noelledavis/sweat-wearable-old/Documentation_graphics_folder/electrolyte_power_pinout.pptx

Top view: component side up!

GND

V+ 3.5V to 5V

FPC

Bluetooth
