noelledavis/sweat-wearable-old/Documentation_graphics_folder/electrode_layout_electrolyte.pptx

Top view: component side up!

Iontophoresis - side

FPC

Sensor Channel 1

Bluetooth
module

Reference

Sensor Channel 2

Iontophoresis + side
