noelledavis/sweat-wearable-old/Documentation_graphics_folder/electrolyte_layout.pptx

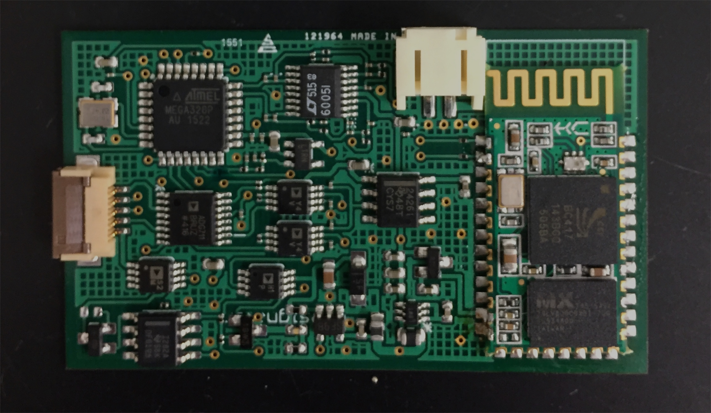
[picture p20: figure]

ATMega328P

Bluetooth

Instrumentation
Amplifier +
filters

Regulators

Analog switches

Current DAC
