noelledavis/sweat-wearable-old/Documentation_graphics_folder/eric4_electrode_layout.pptx

Top view: component side up!

Temperature pin1

Temperature pin2

Current Ch1

10-pin connector

Current reference

USB/switch

Voltage Ch1

Current Ch2

Voltage Ch2

Voltage Ch3

Voltage reference

Voltage Ch4
