noelledavis/sweat-wearable-old/Documentation_graphics_folder/labeled_circuit.pptx

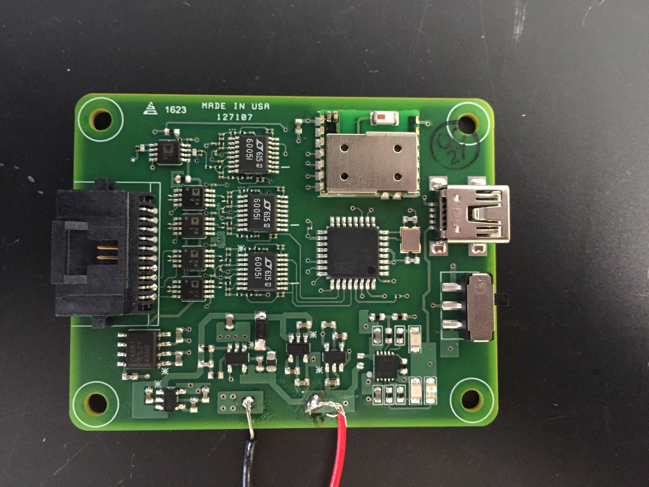
[picture p21: figure]

Current channels

Bluetooth

ATMega328P

ON/OFF switch

Charger

Regulators

Voltage
channels
