noelledavis/sweat-wearable-old/Documentation_graphics_folder/prog_layout_electrolyte.pptx

Remember to flip the board backside up!

GND

MISO

RST

Bluetooth

FPC connector

SCK

MOSI

VDD
