noelledavis/sweat-wearable-old/Documentation_graphics_folder/programmer_pinlayout.pptx

MOSI

VCC

NC

GND

RST

GND

SCK

GND

MISO

GND
