noelledavis/sweat-wearable-old/Documentation_graphics_folder/transfer_board.pptx

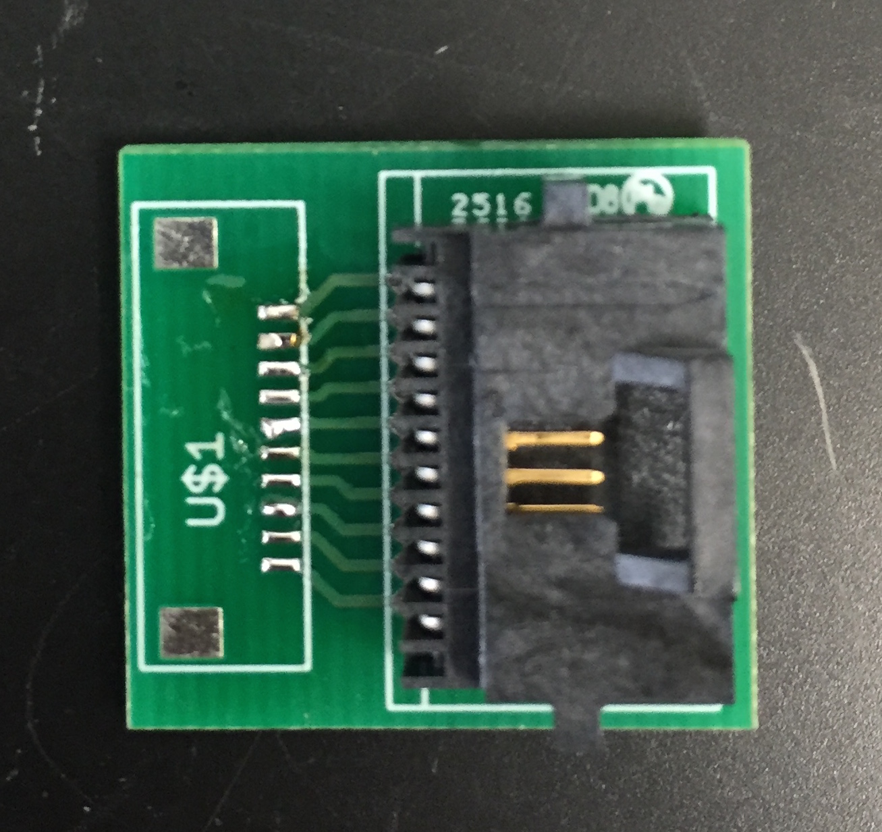
[picture p22: figure]

FPC

10-pin connector
