noelledavis/sweat-wearable-old/Documentation_graphics_folder/tia_frontend.pdf

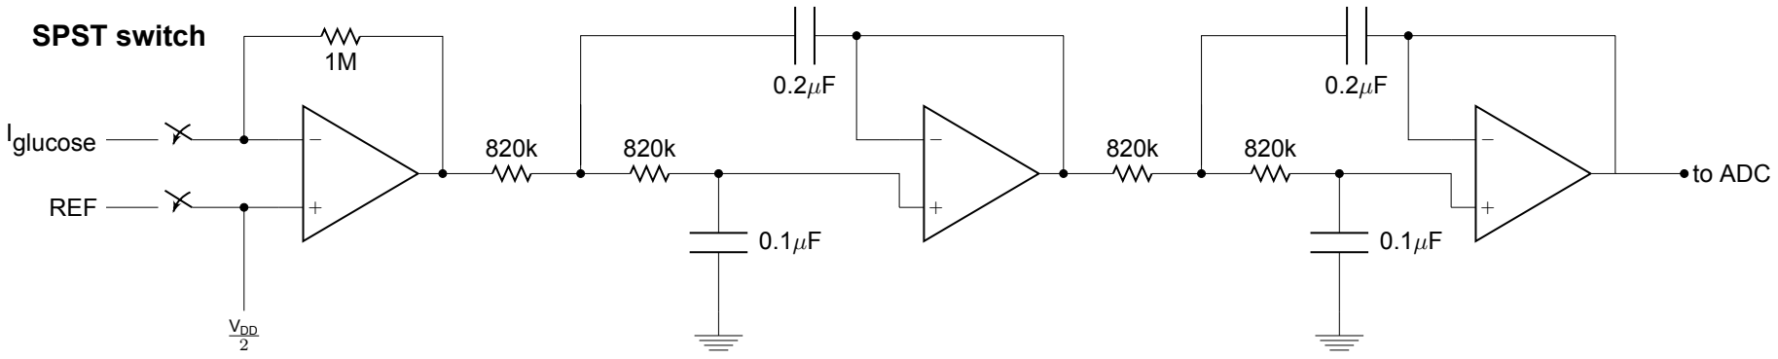
[picture p23: figure]
glucose; VDD 2; REF; SPST switch; to ADC

Transimpedance amplifier

Fourth order low-pass filter
