noelledavis/sweat-wearable-old/electrolyte/currentsource.pdf

# Suggested circuits for voltage-controlled current source for iontophoresis

Eric Wu

May 22, 2015

## 1 Option 1: AD8276 unity-gain difference amplifier and single resistor

We can try using a Howland current pump. The following schematic is taken from a document (http://www.analog.com/library/analogDialogue/cd/vol45n2.pdf) written by Analog Devices, and the datasheet for the IC is at this link. (http://www.analog.com/media/en/technical-documentation/data-sheets/AD8276_8277.pdf)

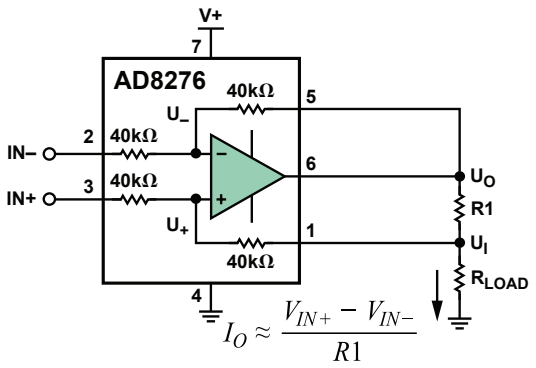
[picture p24: figure]
RLOAD

Setting R = 40 kΩ and VIN− = 0, we get the following nodal equations:

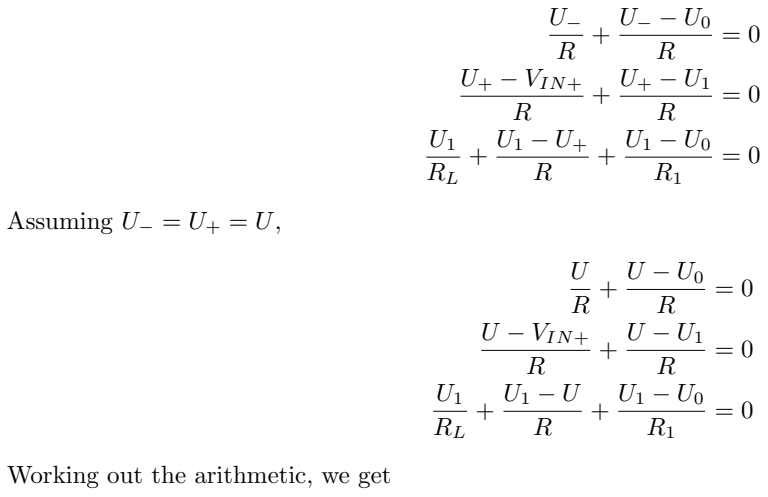
[picture p25: figure]
U+ − VIN+; Assuming U− = U+ = U,; U − VIN+; Working out the arithmetic, we get

1

U1 = VIN+ ·

(RL k 2R)
(R1 k 2R)

and

Iload =

VIN+
(2R k R1)

·

2R
RL + 2R

If we assume that 2R R1 and 2R RL (this last assumption may be a bit shaky, because I don’t exactly know the DC impedance of skin, and the impedance will also have a dependence on the area of the electrodes), we get

Iload =

VIN+
R1

Using the equations and only making the assumption 2R R1, I can find the output impedance, which is approximately 2R = 80kΩ, and therefore we can model the circuit approximately as the following:

VIN+
R1
80kΩ | RL

Depending on what the impedance of skin is, this may or may not be acceptable. If skin ends up having a much higher impedance than this circuit allows, then we may need to use a different IC.
Using R1 = 2kΩ, VDD = 30V, the complete circuit was simulated in HSPICE, with different load resistances.

2

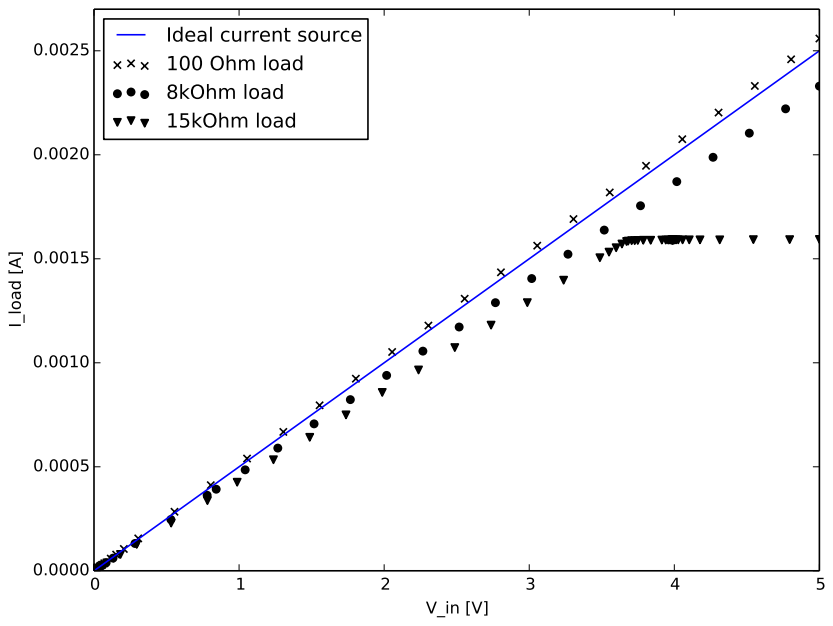
[picture p26: figure]
I_load [A]; Ideal current source; 100 Ohm load; 8kOhm load; 15kOhm load

For large loads (i.e. around 10kΩ and larger), HSPICE shows that the current gets clipped, for large values of current. This is mainly because of the upper bound imposed by VDD.

In summary:

- Vin will most likely be supplied by a DAC.
- Very simple voltage-controlled current source, requiring only a single inexpensive (about $1 or so) IC, and a single resistor
- Load is connected to ground at one end
- If we need more current, or if skin impedance is high, this particular IC is rated up to 36V VDD
- We may want to go with a different IC if skin impedance is excessively high
- It would probably be a good idea to use a unity-gain difference amplifier rather than going the DIY op-amp + resistor approach. The circuit is essentially a Howland current pump, and according to this TI document (http://www.ti.com/lit/an/snoa474a/snoa474a.pdf) the Howland current pump has a strong dependence on resistor variability. The datasheet for the IC claims that the resistors are precisely laser-trimmed, so this should help a lot with variability.

3

## 2 Option 2: AD8276 unity-gain difference amplifier with boost transistor

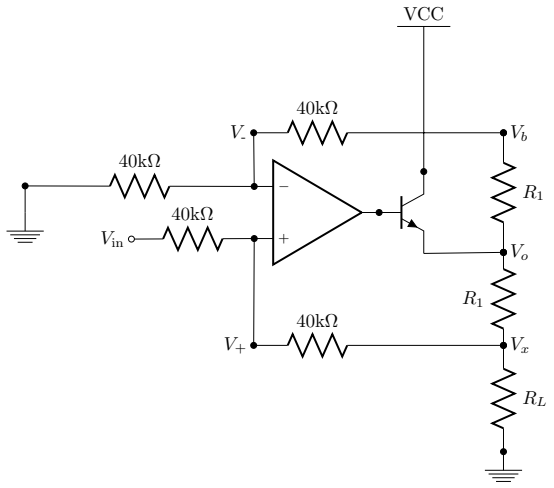
[picture p27: figure]
Vin; VCC

Note that the R = 40kΩ resistors and the op-amp are internal to the AD8276. In this circuit, VDD is the same as before, 30V, and the AD8276 positive and negative supplies are 30V and 0V respectively. This circuit can be solved very simply, using a similar approach to that given previously. The nodal equations are

V−
R

+

V− − Vb
R

= 0

V+ − Vin
R

+

V+ − Vx
R

= 0

Vb − V−
R

+

Vb − Vo
R1

= 0

Vx − V+
R

+

Vx − Vo
R1

+

Vx
RL

= 0

and working out the arithmetic, assuming that V+ = V−, gives

IL =

Vin
(R1 k R)

where R = 40kΩ. With these assumptions the circuit is something very close to an ideal current source. HSPICE simulations were then run for R1 = 2kΩ, and varying values of RL. The results are shown below.

4

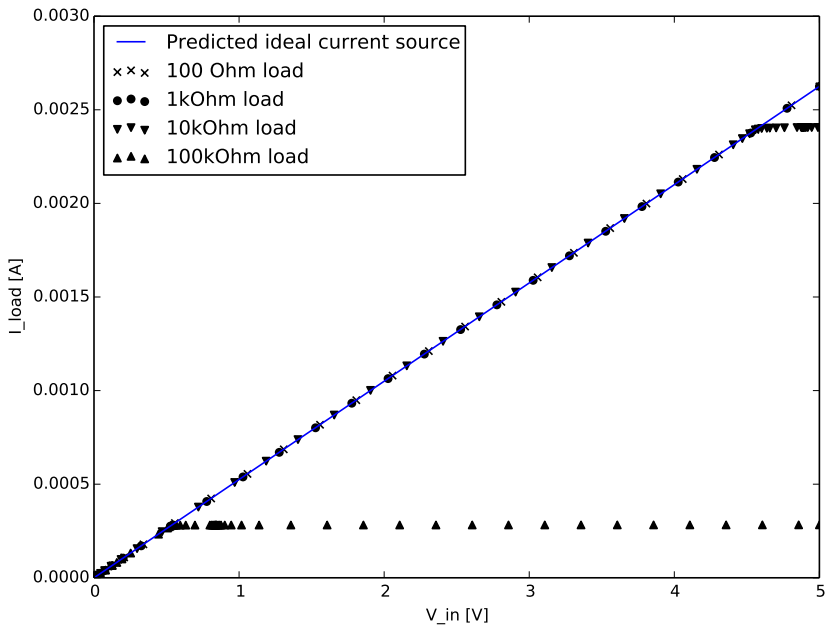
[picture p28: figure]
I_load [A]; Predicted ideal current source; 100 Ohm load; 1kOhm load; 10kOhm load; 100kOhm load

The clipping is brought upon by the upper limit imposed by VDD.

In summary:

- Vin will most likely be supplied by a DAC.
- Closer to an ideal current source than the original circuit
- Load still grounded on one end.
- A bit more complicated than the original circuit, requiring an extra resistor and a BJT
- Analog Devices claims that if the two resistors with value R1 mismatch, there may be some sort of error. Since these resistors are external, we might need high precision resistors/trimmable resistors if we were to build this circuit.

5
