noelledavis/sweat-wearable-old/Documentation_graphics_folder/erci4currentfrontend/tia_frontend.pdf

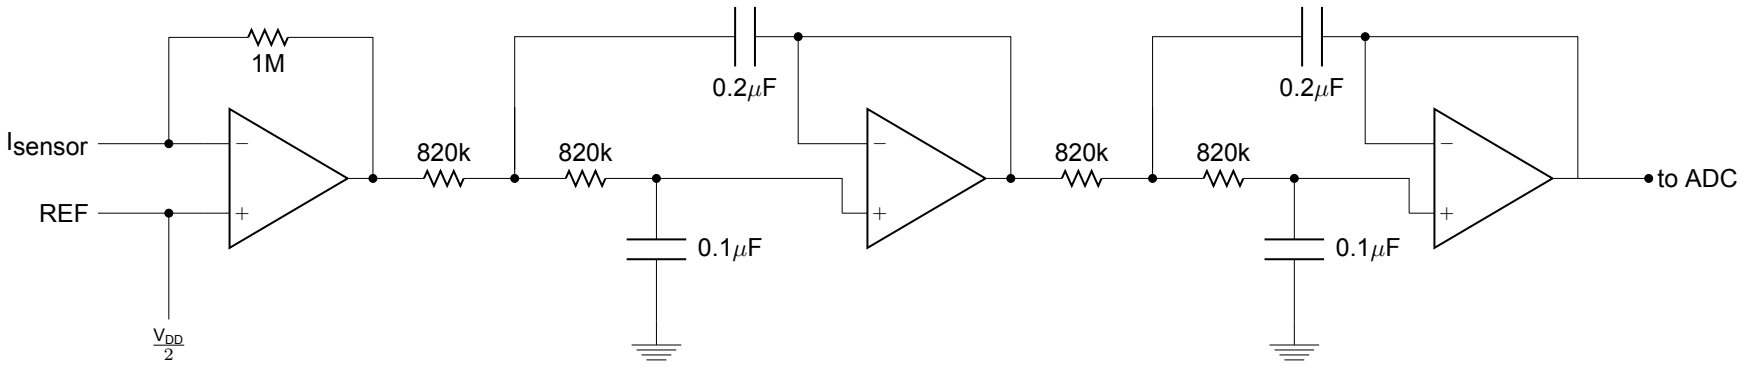
[picture p29: figure]
Isensor; VDD 2; REF; to ADC

Transimpedance amplifier

Fourth order low-pass filter
