noelledavis/sweat-wearable-old/Documentation_graphics_folder/replaceableparts.pptx

R6

R5

JUMPER
