noelledavis/sweat-wearable-old/electrolyte/electrolyte_firmware_FINAL/programming_pins.jpg

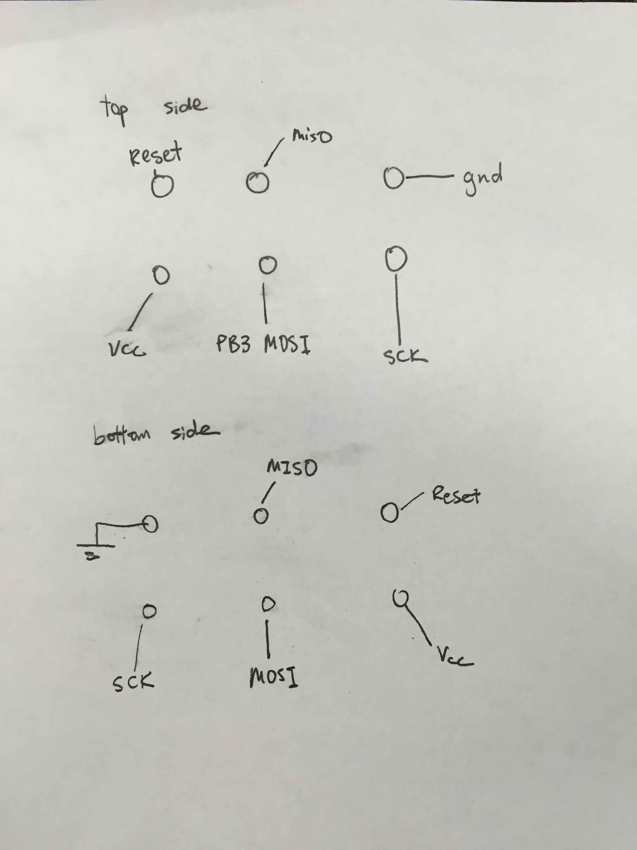
electrolyte/electrolyte_firmware_FINAL/programming_pins.jpg
