noelledavis/sweat-wearable-old/electrolyte/electrolyte_r3_orderfiles/inamp_round3_BOM.xlsx

Item # | Quantity per board | Manufacturer Part # | Do Not Install | Reference designators | Vendor (optional) | Vendor Part Number (optional) | Value (optional) | Size / Footprint (optional) | Part description/ specs (optional, but recommended) | Manfacturer (optional)
1 | 1 | CRCW02011M00FNED |  | R43 | Digikey | 541-1.00MABCT-ND | 1M | R0201 |  | Vishay-Dale
2 | 1 | MMBF5457 |  | Q1 | Digikey | MMBF5457CT-ND | MMBF5457 N-channel JFET | SOT23 |  | Fairchild
3 | 2 | GRM1555C1H200JA01D |  | C25,C26 | Digikey | 490-5930-1-ND | 20pF | C0402 | 20pF capacitor | Murata
4 | 1 | CL05B152KB5NNNC |  | CF | Digikey | 1276-1521-1-ND | 1500pF | C0402 | 50V 1500pF capacitor | Samsung
5 | 1 | LMR64010XMFE/NOPB |  | U2 | Digikey | LMR64010XMFE/NOPBCT-ND |  | SOT23-5 |  | Texas Instruments
6 | 4 | GRM155R60J105KE19D |  | C24,C68,C79,C80 | Digikey | 490-1320-1-ND | 1uF | C0402 |  | Murata
7 | 1 | INA282AIDR |  | U4 | Digikey | 296-27820-1-ND |  | SOIC-8 |  | Texas Instruments
8 | 1 | LT6005IGN#PBF |  | U3 | Digikey | LT6005IGN#PBF-ND |  | 16-SSOP |  | Linear Technologies
9 | 1 | MBR0540L-TP |  | D1 | Digikey | MBR0540L-TPMSTR-ND |  | SOD123 | 40V Schottky diode | Micro Commercial
10 | 1 | MCR006YRTJ390 |  | R26 | Digikey | RHM39CCCT-ND | 39 | R0201 |  | Rohm Semiconductor
11 | 3 | MCR006YRTF1003 |  | R65,R70,R53 | Digikey | RHM100KCBCT-ND | 100k | R0201 |  | Rohm Semiconductor
12 | 1 | CL05A225MQ5NNNC |  | C1 | Digikey | 1276-1469-1-ND | 2.2uF | C0402 |  | Samsung
13 | 1 | ADG711BRUZ |  | U6 | Digikey | ADG711BRUZ-ND |  | 16TSSOP |  | Analog Devices
14 | 1 | BC846B,215 |  | T1 | Digikey | 568-1632-1-ND |  | SOT23 | 65V NPN BJT | NXP Semiconductors
15 | 1 | FH12-5S-1SH(55) |  | U20 | Digikey | HFB105CT-ND |  |  |  | Hirose
16 | 1 |  | DNI | R27
17 | 2 | MLZ2012M100WTD25 |  | L2,L3 | Digikey | 445-17073-1-ND | 10uH | 805 |  | TDK
18 | 1 | ERJ-2RKF1332X |  | R4 | Digikey | P13.3KLCT-ND | 13.3k | R0402 |  | Panasonic
19 | 6 | CL05A106MQ5NUNC |  | C8,C13,C23,C27,C36,C74 | Digikey | 1276-1451-1-ND | 10uF capacitor | C0402 |  | Samsung
20 | 1 | LTC3525ESC6-5#TRMPBF |  | U12 | Digikey | LTC3525ESC6-5#TRMPBFCT-ND |  | SC70 | 5V boost regulator | Linear Technologies
21 | 1 | LT1800CS5#TRMPBF |  | U$5 | Digikey | LT1800CS5#TRMPBFCT-ND |  | TSOT23-5 |  | Linear Technologies
22 | 8 | ERJ-1GEF8203C |  | R10,R11,R13,R14,R20,R21,R23,R24 | Digikey | P820KABCT-ND | 820k | R0201 |  | Panasonic
23 | 2 | RC0201JR-0720KL |  | R44,R45 | Digikey | 311-20KNCT-ND | 20k | R0201 |  | Yageo
24 | 1 | S2B-PH-SM4-TB(LF)(SN) |  | CN1 | Digikey | 455-1749-1-ND |  |  | JST-PH 2 pin connector | JST
25 | 23 | GRM033R60J104KE19D |  | C3,C4,C5,C6,C7,C9,C10,C11,C12,C14,C15,C16,C17,C18,C19,C20,C21,C22,C31,C32,C33,C34,C28 | Digikey | 490-3167-1-ND | 0.1uF capacitor | C0201 |  | Murata
26 | 1 | ADG5401BRMZ |  | U$1 | Digikey | ADG5401BRMZ-ND |  |  |  | Analog Devices
27 | 1 | AP7313-33SAG-7 |  | IC2 | Digikey | AP7313-33SAG-7DICT-ND |  | SOT23 | 3.3V LDO | Diodes Incorporated
28 | 1 | GRM155R61A104KA01D |  | C76 | Digikey | 490-1318-1-ND | 0.1uF capacitor | C0402 |  | Murata
29 | 1 | C1608X5R1V475M080AC |  | C2 | Digikey | 445-9042-1-ND | 4.7uF capacitor | C0603 | 35V capacitor | TDK
30 | 2 | AD8422BRMZ |  | U7,U8 | Digikey | AD8422BRMZ-ND |  | 8-MSOP | Instrumentation amplifier | Analog Devices
31 | 1 | C0603X5R0J105M030BC |  | C30 | Digikey | 445-8008-1-ND | 1uF capacitor | C0201 |  | TDK
32 | 1 | AD8276ARMZ-R7 |  | U1 | Digikey | AD8276ARMZ-R7TR-ND |  | 8-MSOP |  | Analog Devices
33 | 1 | ATMEGA328P-AUR |  | U5 | Digikey | ATMEGA328P-AURCT-ND |  | 32-TQFP |  | Atmel
34 | 1 | NX3225SA-16.000000MHZ-T1 |  | Q3 | Digikey | 644-1100-1-ND |  |  | 16 MHz oscillator | NDK
35 | 2 | CRCW02012K20FKED |  | R1,R2 | Digikey | 541-2.20KAABCT-ND | 2.2k | R0201 |  | Vishay-Dale
36 | 2 | ERJ-1GEF4991C |  | R5,R7 | Digikey | P4.99KABTR-ND | 4.99k | R0201 |  | Panasonic
37 | 1 | CRCW0402374KFKED |  | R3 | Digikey | 541-374KLCT-ND | 374k | R0402 |  | Vishay-Dale
38 | 1 | TLE2426IDR |  | U15 | Digikey | 296-1345-1-ND |  | 8_SOIC |  | Texas Instruments
39 | 1 | RC0201JR-0710KL |  | R6 | Digikey | 311-10KNCT-ND | 10k | R0201 | 10k | Yageo
40 | 1 |  | DNI | U13
