noelledavis/sweat-wearable-old/eric4/files_for_order/everything_board_partlist_bom.xlsx

Item # | Quantity per board | Manufacturer Part # | Do Not Install | Reference designators | Vendor (optional) | Vendor Part Number (optional) | Value (optional) | Size / Footprint (optional) | Part description/ specs (optional, but recommended) | Manfacturer (optional)
1 | 3 | ERJ-2RKF1500X |  | R7;R8;R38 | Digikey | P150LCT-ND | 150 | R402 |  | Panasonic
2 | 2 |  | DNI | BATT_NEG;BATT_POS
3 | 2 | CRCW02011M00FNED |  | R35;R36 | Digikey | 541-1.00MABCT-ND | 1M | R0201 |  | Vishay-Dale
4 | 1 | LG R971-KN-1 |  | LED2 | Digikey | 475-1410-1-ND | STAT2-GREEN | CHIPLED_0805 |  | Osram-opto-semiconductors
5 | 1 | LH R974-LP-1 |  | LED3 | Digikey | 475-1415-1-ND | Power-RED | CHIPLED_0805 |  | Osram-opto-semiconductors
6 | 1 | LTST-C170KFKT |  | LED1 | Digikey | 160-1413-1-ND | STAT1-ORANGE | CHIPLED_0805 |  | Lite-on inc
7 | 4 | GRM155R60J105KE19D |  | C30;C34;C38;C58 | Digikey | 490-1320-1-ND | 1uF | C0402 |  | Murata
8 | 1 | GRM1555C1H431GA01D |  | C55 | Digikey | 490-6240-1-ND | 430p | C0402 |  | Murata
9 | 1 | RC0402JR-07150KL |  | RT2 | Digikey | 311-150KJRTR-ND | 150k | R0402 |  | Yageo
10 | 1 | RC0402JR-071KL |  | RT1 | Digikey | 311-1.0KJRCT-ND | 1K | R0402 |  | Yageo
11 | 3 | LT6005IGN#PBF |  | U2;U3;U4 | Digikey | LT6005IGN#PBF-ND |  | 16-SSOP |  | Linear Technologies
12 | 3 | GRM155R71H103KA88D |  | C4;C8;C57 | Digikey | 490-4516-1-ND | 0.01u | C0402 |  | Murata
13 |  |  | DNI | J1
14 | 1 | ATMEGA328P-AUR |  | U10 | Digikey | ATMEGA328P-AURCT-ND |  | 32-TQFP |  | Atmel
15 | 1 | AD8642ARMZ |  | U$6 | Digikey | AD8642ARMZ-ND | AD8462 | MSOP08 |  | Analog Devices
16 | 1 | MCP73833T-AMI/MF |  | U5 | Mouser | 579-MCP73833T-AMI/MF | MCP73833T-AMI/MF | DFN10_3X3MM |  | Microchip
17 | 1 | 5-104074-1 |  | U$12 | Digikey | A31852-ND | 5-104074-1-CONNECTOR | 5-104074-1-CONNECTOR |  | TE Connectivity
18 | 1 | CL05A225MQ5NNNC |  | C54 | Digikey | 1276-1469-1-ND | 2.2uF | C0402 |  | Samsung
19 | 1 | MBR0520LT1G |  | D1 | Digikey | MBR0520LT1GOSTR-ND | MBR0520LT | SOD123 |  | ON Semiconductor
20 | 2 | LP3985IM5-5.0/NOPB |  | U$5;U$7 | Digikey | LP3985IM5-5.0/NOPBCT-ND | LP3985A-50 | SOT95P280X145-5N |  | Texas Instruments
21 | 2 | GJM1555C1HR10BB01D |  | C51;C52 | Digikey | 490-3077-1-ND | 0.1p | C0402 | 0.1pF capacitor | Murata
22 | 1 | 10033526-N3212LF |  | U$10 | Digikey | 609-4700-1-ND | MINI-USB-10033526-N3212LF | MINI-USB-10033526-N3212LF | USB - mini B Receptacle Connector 5 Position Surface Mount, Right Angle, Horizontal | Amphenol FCI
23 | 4 | ERJ-1GEF4991C |  | R1;R2;R3;R4 | Digikey | P4.99KABCT-ND | 4.99k | R0201 |  | Panasonic
24 | 1 | MLZ2012M100WTD25 |  | L2 | Digikey | 445-17073-1-ND | 10uH | 805 |  | TDK
25 | 1 | RC0402FR-0746K4L |  | R26 | Digikey | 311-46.4KLRCT-ND | 46.4k | R0402 |  | Yageo
26 | 1 | RC0402FR-0713K3L |  | R25 | Digikey | YAG2974CT-ND | 13.3k | R0402 |  | Yageo
27 | 1 | MCR006YRTF1003 |  | R42 | Digikey | RHM100KCBCT-ND | 100k | R0201 |  | Rohm Semiconductor
28 | 5 | CL05A106MQ5NUNC |  | C29;C36; C53;C49;C67 | Digikey | 1276-1451-1-ND | 10uF capacitor | C0402 |  | Samsung
29 | 2 | ERJ-2RKF2001X |  | R6;R39 | Digikey | P2.00KLCT-ND | 2k | R0402 |  | Panasonic
30 | 1 | RC0402JR-0710KL |  | R40 | Digikey | 311-10KJRCT-ND | 10K/THERM | R0402 |  | Yageo
31 | 3 | GRM155R60J475ME47D |  | C32;C33;C56 | Digikey | 490-5915-1-ND | 4.7u | C0402 |  | Murata
32 | 24 | ERJ-1GEF8203C |  | R9;R10;R11;R12;R13;R14;R15;R16;R17;R18;R19;R20;R21;R22;R23;R24;R27;R28;R29;R30;R31;R32;R33;R34 | Digikey | P820KABCT-ND | 820k | R0201 |  | Panasonic
33 | 1 |  | DNI | JUMPER
34 | 1 | RC0402JR-0710KL |  | R5 | Digikey | 311-10KJRCT-ND | 10k | R0402 |  | Yageo
35 | 1 | LP3985IM5-3.3/NOPB |  | U1 | Digikey | LP3985IM5-3.3/NOPBCT-ND | LP3985IM5-3.3/NOPB | SOT95P280X145-5N |  | Texas Instruments
36 | 1 | SPBT2632C2A.AT2 |  | U$8 | Digikey | 497-13189-ND | SPBT2632C2A | SPBT2632C2A |  | STMicroelectronics
37 | 1 | GRM155R61A104KA01D |  | C61 | Digikey | 490-1318-1-ND | 0.1uF capacitor | C0402 |  | Murata
38 | 46 | GRM033R60J104KE19D |  | C1;C2;C3;C5;C6;C7;C9;C10;C11;C12;C13;C14;C15;C16;C17;C18;C19;C20;C21;C22;C23;C24;C25;C26;C27;C28;C31;C35;C37;C39;C40;C41;C42;C43;C44;C45;C46;C47;C48;C50;C60;C62;C63;C64;C68;C69 | Digikey | 490-3167-1-ND | 0.1uF capacitor | C0201 |  | Murata
39 | 4 | AD8422BRMZ |  | U$1;U$2;U$3;U$4 | Digikey | AD8422BRMZ-ND |  | 8-MSOP | Instrumentation amplifier | Analog Devices
40 | 1 | LM27313XMFX/NOPB |  | U$9 | Digikey | 296-35164-1-ND | LM27313 | SOT95P280X145-5N |  | Texas Instruments
41 | 1 | NX3225SA-16.000000MHZ-T1 |  | Q1 | Digikey | 644-1100-1-ND |  |  | 16 MHz oscillator | NDK
42 | 2 | GRM1555C1H200JA01D |  | C65;C66 | Digikey | 490-5930-1-ND | 20pF | C0402 | 20pF capacitor | Murata
43 | 1 | TLE2426IDR |  | U15 | Digikey | 296-1345-1-ND |  | 8_SOIC |  | Texas Instruments
44 | 1 | JS102011SAQN |  | U$11 | Digikey | 401-1999-1-ND | JS102011SAQN | JS102011SAQN |  | C&K Components
