noelledavis/sweat-wearable-old/Documentation_graphics_folder/prog_instructions.pptx

Remember to flip the board backside up!

MISO

SCK

RST

Switch and USB

10-pin connector

VDD

MOSI

GND
