noelledavis/sweat-wearable-old/eric4/fullboard_eaglefiles/untitled.pdf

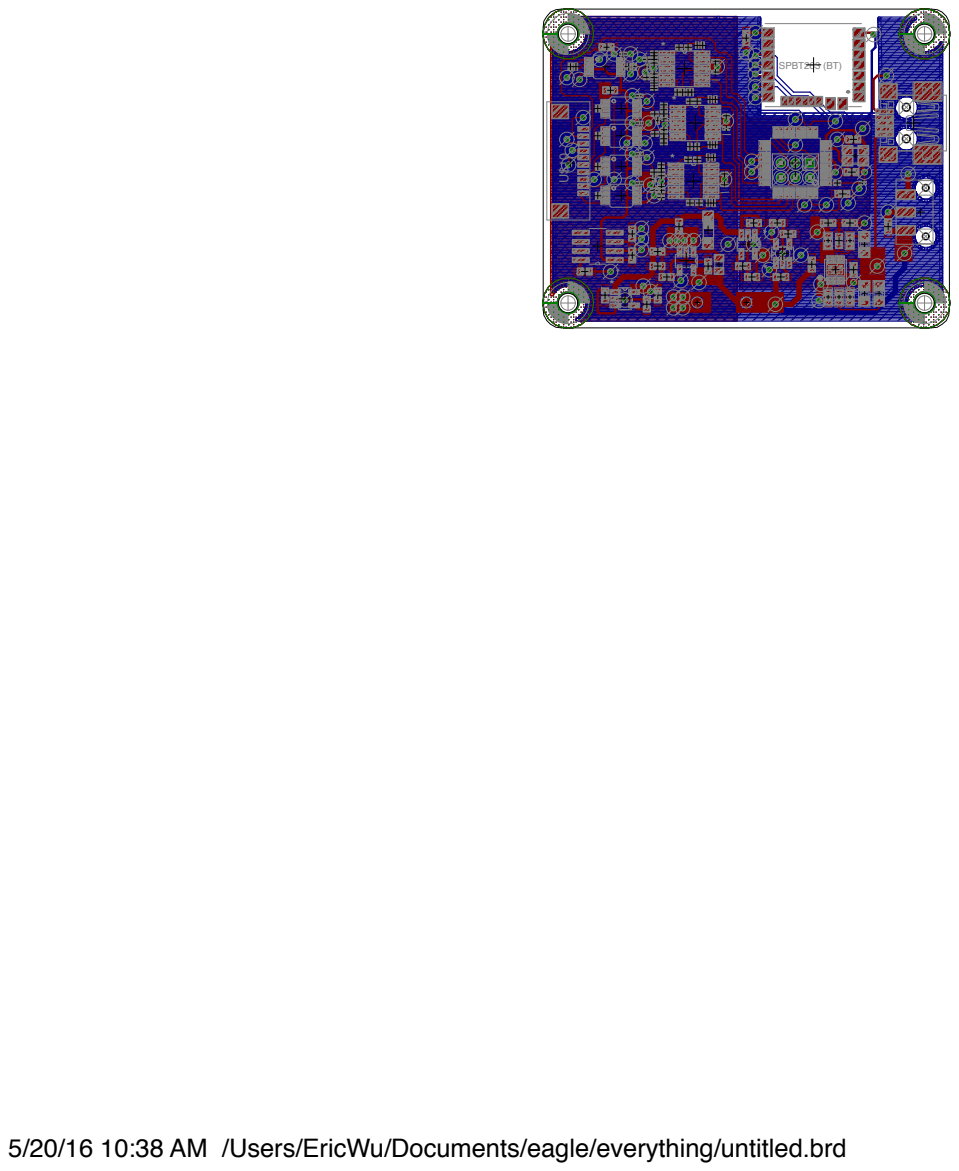
[picture p31: page 1]
SPBT263 (BT)

5/20/16 10:38 AM /Users/EricWu/Documents/eagle/everything/untitled.brd
