noelledavis/sweat-wearable-old/electrolyte/electrolyte_eaglefiles/untitled.brd

## EAGLE design electrolyte/electrolyte_eaglefiles/untitled.brd (2020-10-29)

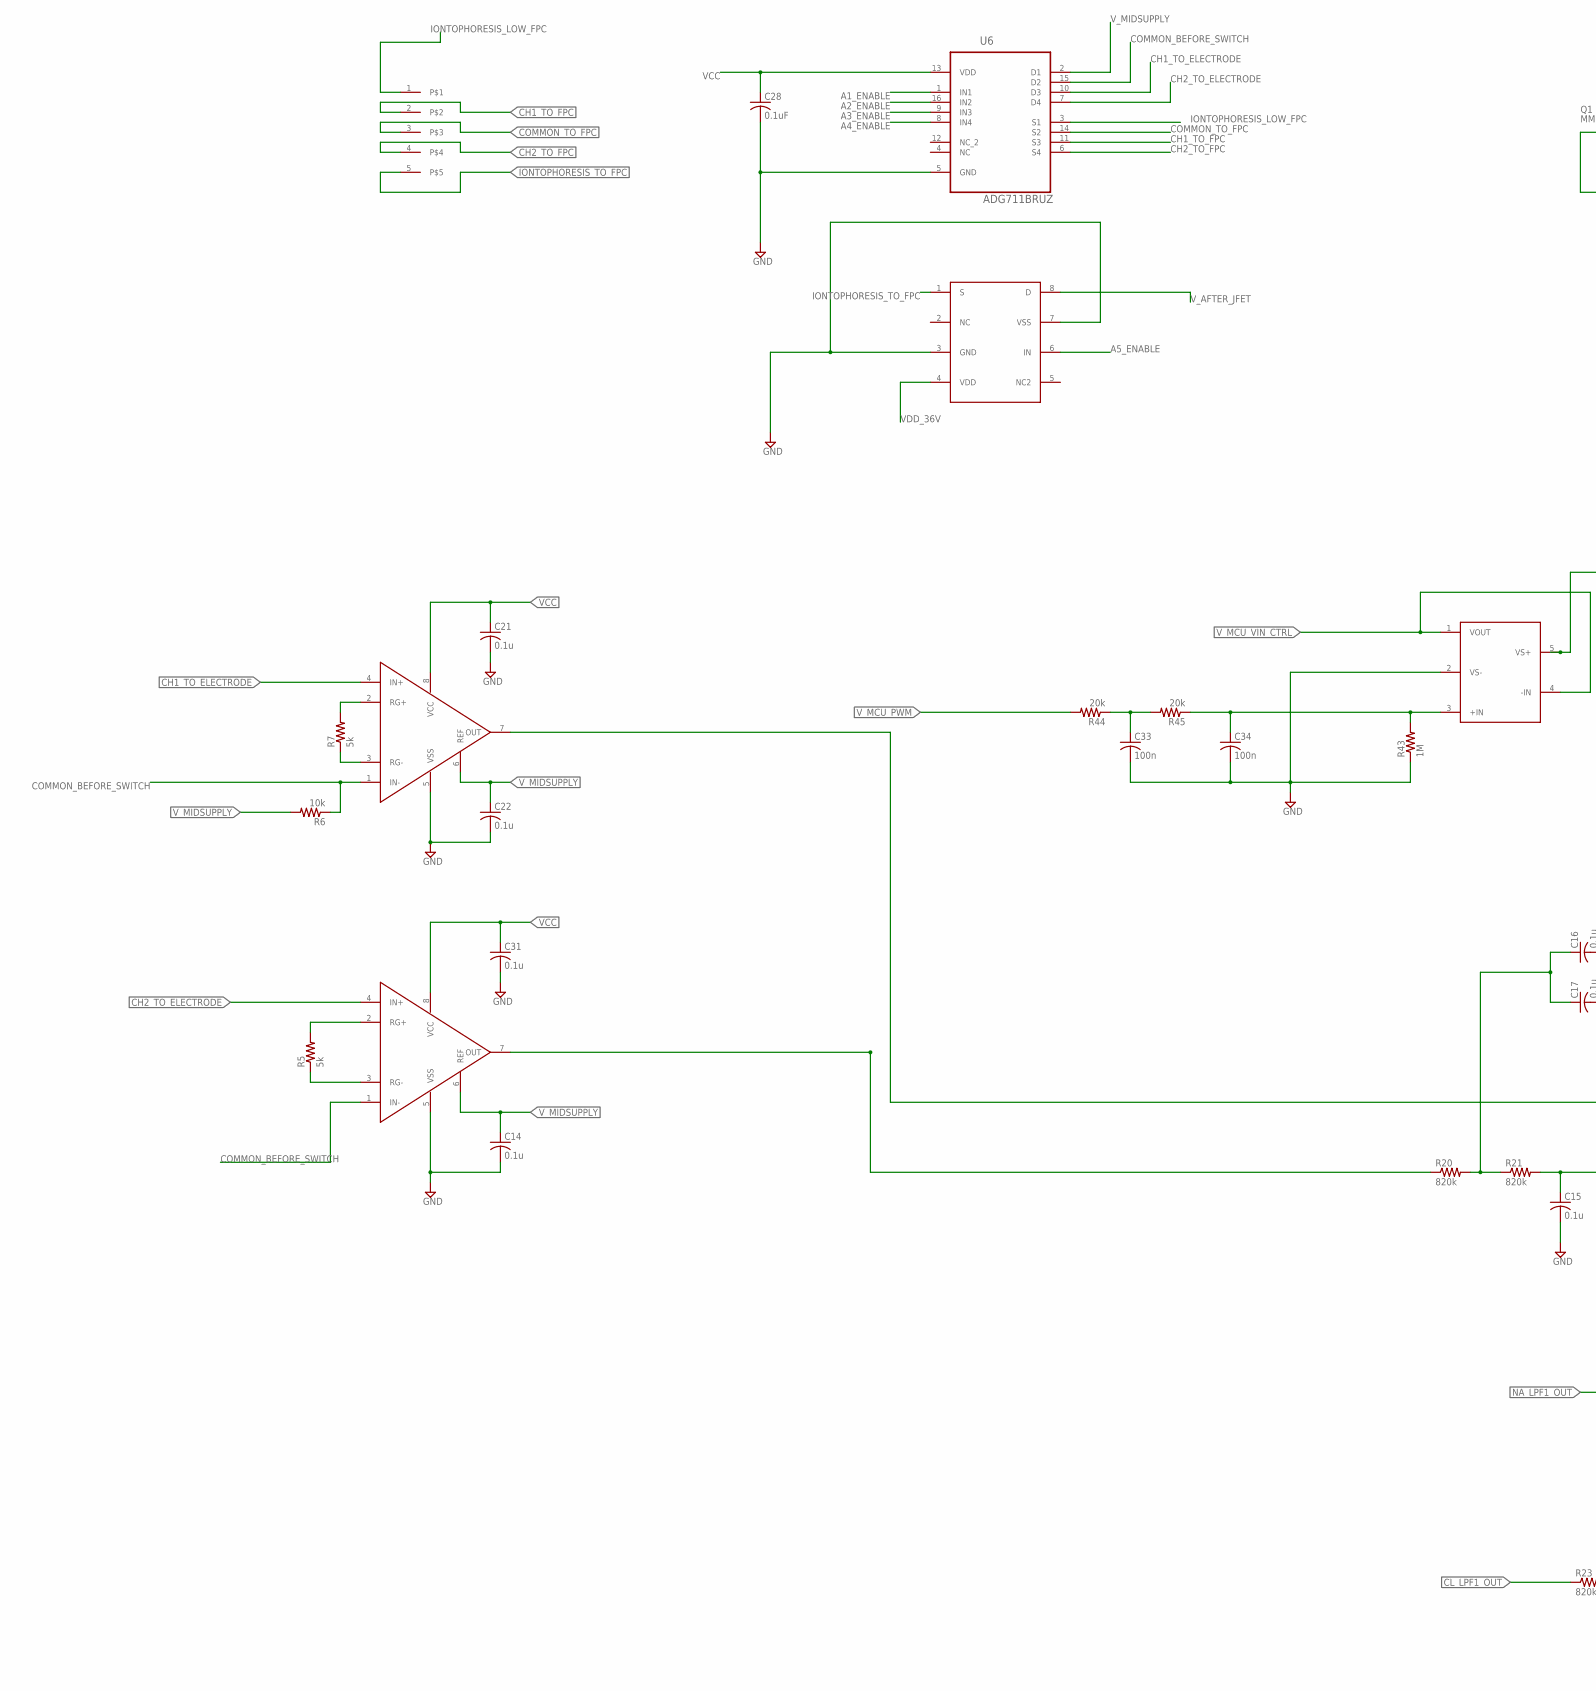
[picture p32: schematic untitled.sch, part in row 1, column 1]

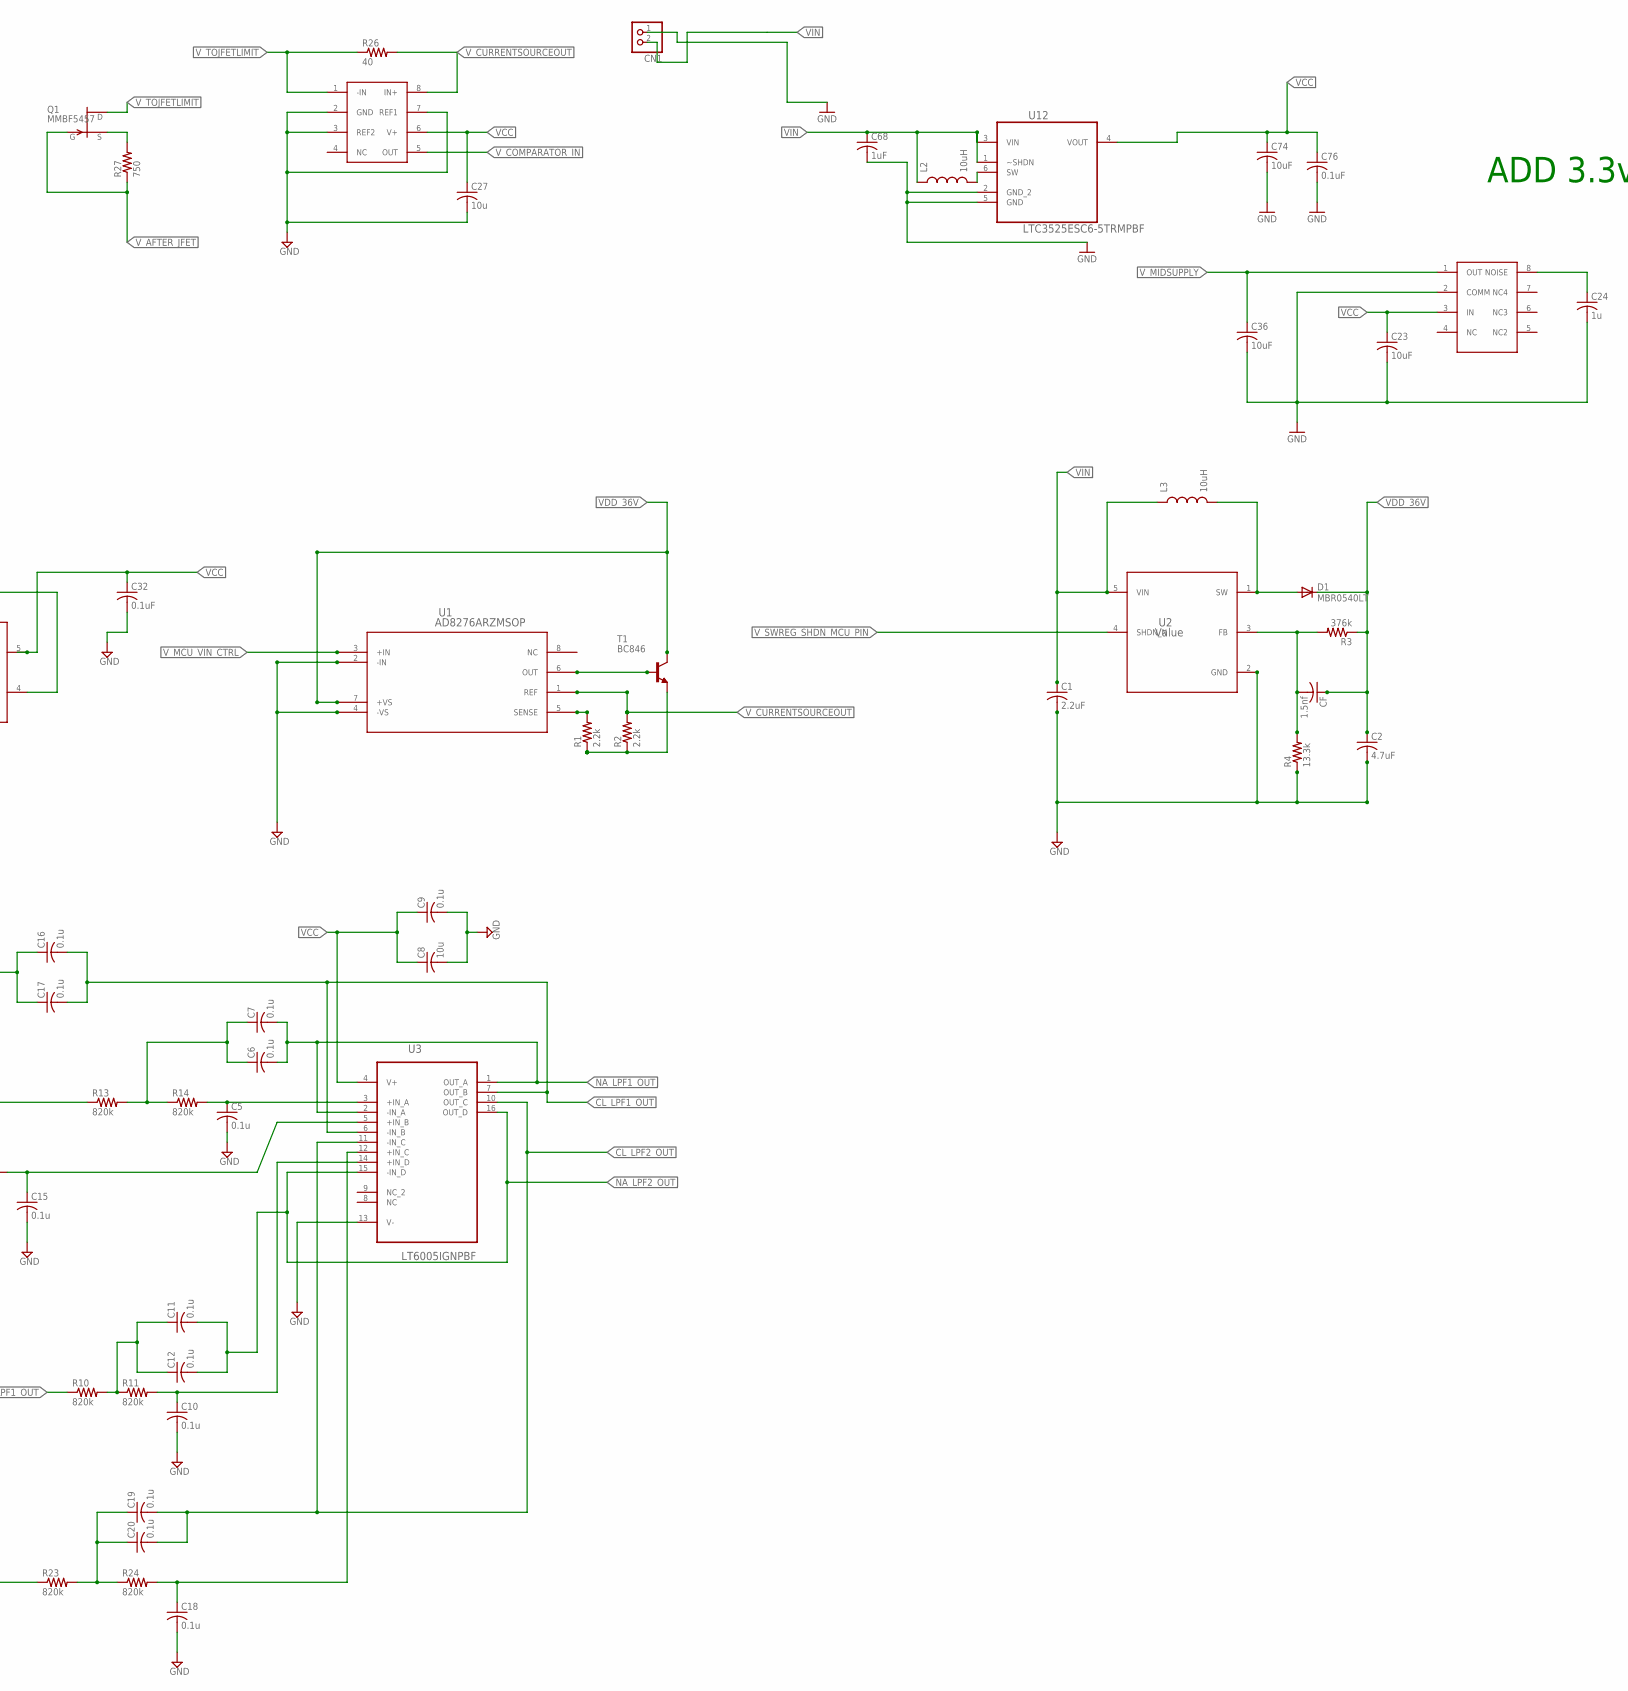
[picture p33: schematic untitled.sch, part in row 1, column 2]

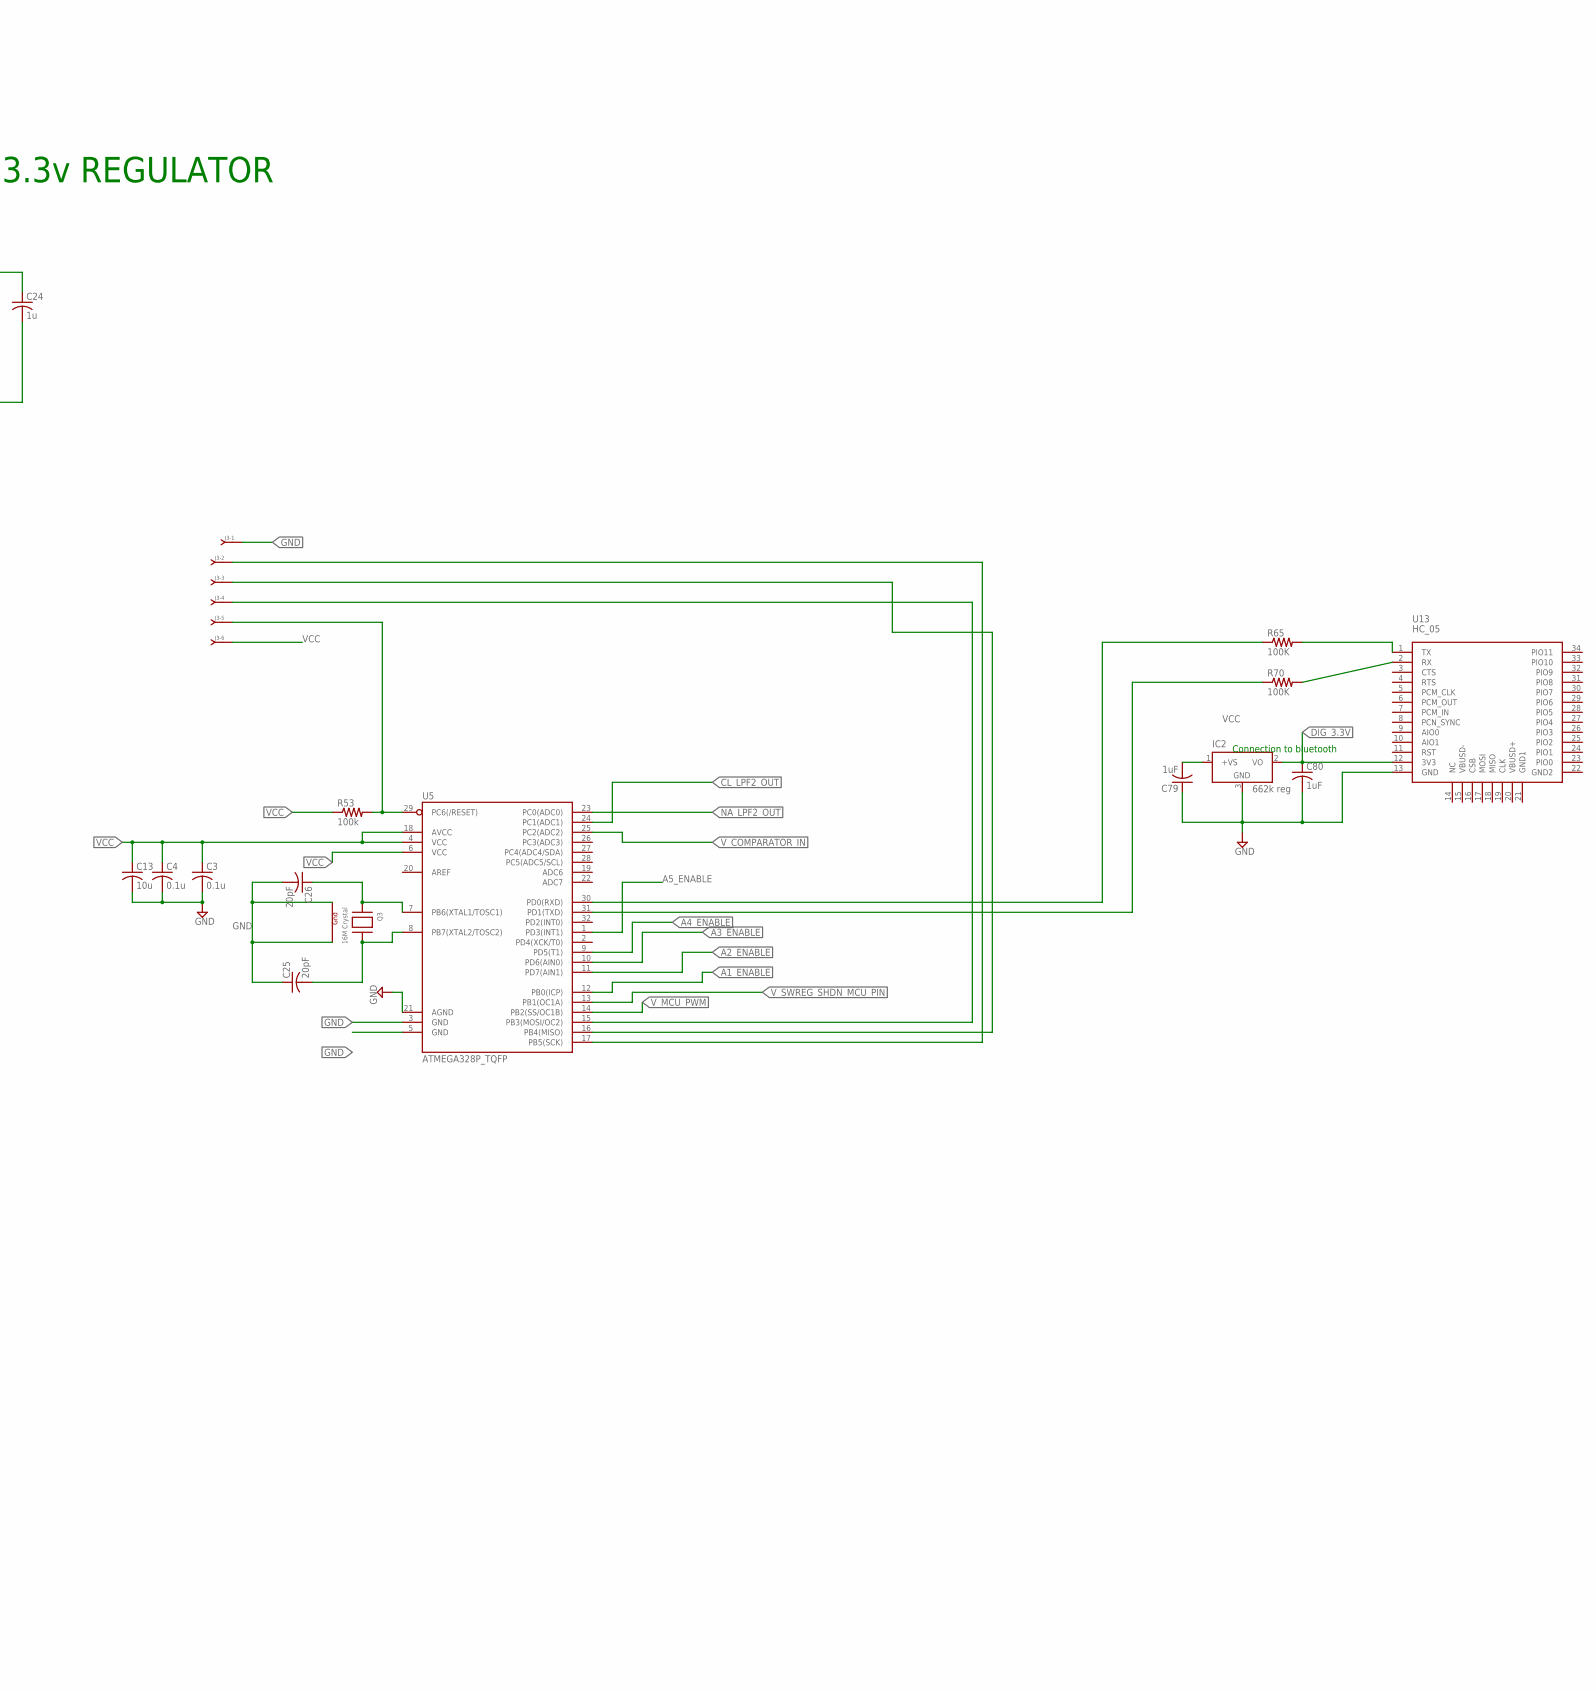
[picture p34: schematic untitled.sch, part in row 1, column 3]

Parts:
C1: 2.2uF; C0402
C2: 4.7uF; C0603
C3, C4, C5, C6, C7, C9, C10, C11, C12, C14, C15, C16, C17, C18, C19, C20, C21, C22, C31: 0.1u; C0201
C8, C13, C27: 10u; C0402
C23, C36, C74: 10uF; C0402
C24: 1u; C0402
C25, C26: 20pF; C0402
C28, C32: 0.1uF; C0201
C33, C34: 100n; C0201
C68, C79, C80: 1uF; C0402; MPN MC0402X105M6R3CT
C76: 0.1uF; C0402
CF: 1.5nf; C0402
CN1: JST_2PIN-SMT; JST-PH-2-SMT
D1: MBR0540LT; SOD123
IC2: 662k reg; SOT23; MPN LM5008MM/NOPB
J3: J-06-100-2X03; HDR-100-2X03
L2, L3: 10uH; 0805
Q1: MMBF5457; SOT23
Q3: 16M Crystal; NX3225
R1, R2: 2.2k; R0201
R3: 376k; R0402
R4: 13.3k; R0402
R5, R7: 5k; R0201
R6: 10k; R0201
R10, R11, R13, R14, R20, R21, R23, R24: 820k; R0201
R26: 40; R0201
R27: 750; R0402
R43: 1M; R0201
R44, R45: 20k; R0201
R53: 100k; R0201
R65, R70: 100K; R0201
T1: BC846; SOT23
U1: AD8276ARZMSOP; MSOP08
U2: Value; DBV0005A_N
U3: LT6005IGNPBF; SOP63P600X175-16N
U4: INA282; SO08
U5: ATMEGA328P_TQFP; TQFP32-08
U6: ADG711BRUZ; SOP65P640X120-16N
U7, U8: SOIC8_INAMPMSOP; MSOP08
U12: LTC3525ESC6-5TRMPBF; SOT65P210X100-6N
U13: HC_05; BLUETOOTH_SMD
U15: TLE2426IDR; R_8
U20: FH12-5S-1SH
U$1: ADG5401; MSOP08
U$5: LT1800; SOT23-5

Connections:
A1_ENABLE: U5.12 (PB0(ICP)), U6.1 (IN1)
A2_ENABLE: U5.11 (PD7(AIN1)), U6.16 (IN2)
A3_ENABLE: U5.10 (PD6(AIN0)), U6.9 (IN3)
A4_ENABLE: U5.9 (PD5(T1)), U6.8 (IN4)
A5_ENABLE: U5.1 (PD3(INT1)), U$1.6 (IN)
CH1_TO_ELECTRODE: U6.10 (D3), U7.4 (IN+)
CH1_TO_FPC: U6.11 (S3), U20.2
CH2_TO_ELECTRODE: U6.7 (D4), U8.4 (IN+)
CH2_TO_FPC: U6.6 (S4), U20.4
CL_LPF1_OUT: C16.2, C17.2, R23.1, U3.6 (-IN_B), U3.7 (OUT_B)
CL_LPF2_OUT: C19.2, C20.2, U3.10 (OUT_C), U3.11 (-IN_C), U5.24 (PC1(ADC1))
COMMON_BEFORE_SWITCH: R6.1, U6.15 (D2), U7.1 (IN-), U8.1 (IN-)
COMMON_TO_FPC: U6.14 (S2), U20.3
DIG_3.3V: C80.1, IC2.2 (VO), U13.12 (3V3)
GND: C1.2, C2.2, C3.2, C4.2, C5.2, C8.2, C9.2, C10.2, C13.2, C14.2, C15.2, C18.2, C21.2, C22.2, C23.2, C24.2, C25.1, C26.2, C27.2, C28.2, C31.2, C32.2, C33.2, C34.2, C36.2, C68.2, C74.2, C76.2, C79.1, C80.2, CN1.1 (2), IC2.3 (GND), J3.1, Q3.2 (G2), Q3.4 (G1), R4.1, R43.1, U1.2 (-IN), U1.4 (-VS), U2.2 (GND), U3.13 (V-), U4.2 (GND), U4.3 (REF2), U4.7 (REF1), U5.3 (GND), U5.5 (GND), U5.21 (AGND), U6.5 (GND), U7.5 (VSS), U8.5 (VSS), U12.2 (GND_2), U12.5 (GND), U13.13 (GND), U15.2 (COMM), U$1.3 (GND), U$1.7 (VSS), U$5.2 (VS-)
IONTOPHORESIS_LOW_FPC: U6.3 (S1), U20.1
IONTOPHORESIS_TO_FPC: U20.5, U$1.1 (S)
unnamed: T1.1 (B), U1.6 (OUT)
unnamed: R13.1, U7.7 (OUT)
unnamed: R1.2, U1.5 (SENSE)
unnamed: R1.1, R2.1, T1.2 (E)
unnamed: R20.1, U8.7 (OUT)
unnamed: R5.1, U8.3 (RG-)
unnamed: CF.2, R3.2, R4.2, U2.3 (FB)
unnamed: R5.2, U8.2 (RG+)
unnamed: R65.1, U5.30 (PD0(RXD))
unnamed: C10.1, R11.2, U3.14 (+IN_D)
unnamed: C5.1, R14.2, U3.3 (+IN_A)
unnamed: Q1.2 (S), R27.2
unnamed: C6.1, C7.1, R13.2, R14.1
unnamed: C11.1, C12.1, R10.2, R11.1
unnamed: R7.1, U7.3 (RG-)
unnamed: R7.2, U7.2 (RG+)
unnamed: C24.1, U15.8 (NOISE)
unnamed: C15.1, R21.2, U3.5 (+IN_B)
unnamed: C16.1, C17.1, R20.2, R21.1
unnamed: C18.1, R24.2, U3.12 (+IN_C)
unnamed: C19.1, C20.1, R23.2, R24.1
unnamed: J3.5, R53.2, U5.29 (PC6(/RESET))
unnamed: L2.2, U12.6 (SW)
unnamed: C25.2, Q3.3 (X2), U5.8 (PB7(XTAL2/TOSC2))
unnamed: C34.1, R43.2, R45.1, U$5.3 (+IN)
unnamed: C33.1, R44.1, R45.2
unnamed: C26.1, Q3.1 (X1), U5.7 (PB6(XTAL1/TOSC1))
unnamed: R65.2, U13.1 (TX)
unnamed: J3.4, U5.15 (PB3(MOSI/OC2))
unnamed: J3.2, U5.17 (PB5(SCK))
unnamed: J3.3, U5.16 (PB4(MISO))
unnamed: R70.1, U5.31 (PD1(TXD))
unnamed: R70.2, U13.2 (RX)
NA_LPF1_OUT: C6.2, C7.2, R10.1, U3.1 (OUT_A), U3.2 (-IN_A)
NA_LPF2_OUT: C11.2, C12.2, U3.15 (-IN_D), U3.16 (OUT_D), U5.23 (PC0(ADC0))
PIN1: D1.A, L3.2, U2.1 (SW)
VCC: C3.1, C4.1, C8.1, C9.1, C13.1, C21.1, C23.1, C27.1, C28.1, C31.1, C32.1, C74.1, C76.1, C79.2, IC2.1 (+VS), J3.6, R53.1, U3.4 (V+), U4.6 (V+), U5.4 (VCC), U5.6 (VCC), U5.18 (AVCC), U6.13 (VDD), U7.8 (VCC), U8.8 (VCC), U12.4 (VOUT), U15.3 (IN), U$5.5 (VS+)
VDD_36V: C2.1, CF.1, D1.C, R3.1, T1.3 (C), U1.7 (+VS), U$1.4 (VDD)
VIN: C1.1, C68.1, CN1.2 (1), L2.1, L3.1, U2.5 (VIN), U12.1 (~SHDN), U12.3 (VIN)
V_AFTER_JFET: Q1.3 (G), R27.1, U$1.8 (D)
V_COMPARATOR_IN: U4.5 (OUT), U5.25 (PC2(ADC2))
V_CURRENTSOURCEOUT: R2.2, R26.2, U1.1 (REF), U4.8 (IN+)
V_MCU_PWM: R44.2, U5.14 (PB2(SS/OC1B))
V_MCU_VIN_CTRL: U1.3 (+IN), U$5.1 (VOUT), U$5.4 (-IN)
V_MIDSUPPLY: C14.1, C22.1, C36.1, R6.2, U6.2 (D1), U7.6 (REF), U8.6 (REF), U15.1 (OUT)
V_SWREG_SHDN_MCU_PIN: U2.4 (SHDN_N), U5.13 (PB1(OC1A))
V_TOJFETLIMIT: Q1.1 (D), R26.1, U4.1 (-IN)

Notes on the sheet:
ADD 3.3v REGULATOR
Connection to bluetooth

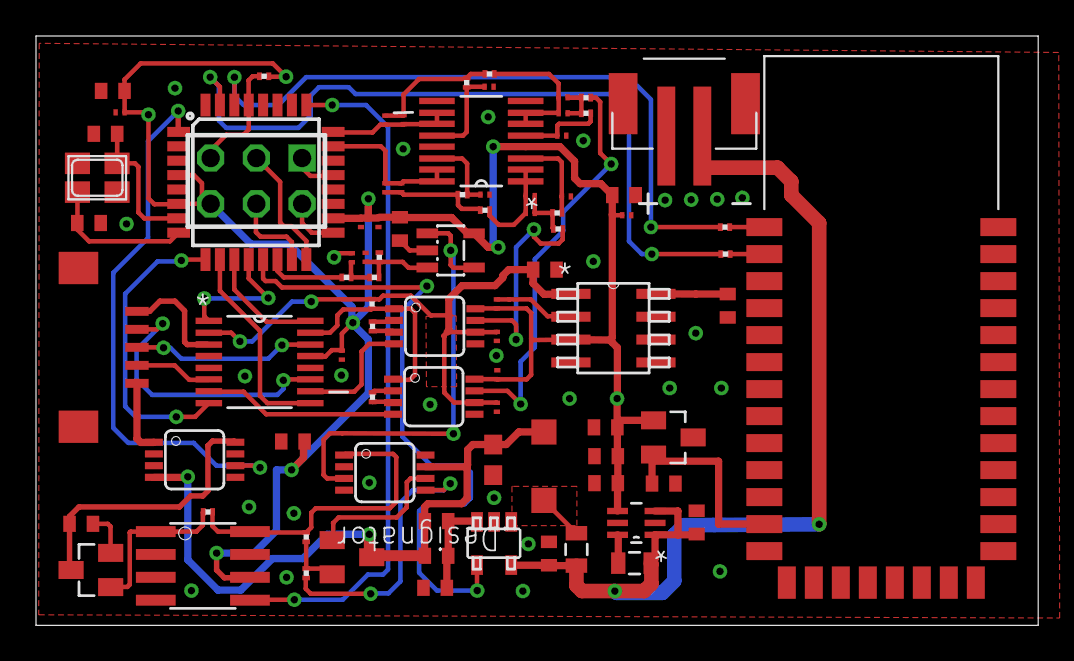
[picture p35: board electrolyte/electrolyte_eaglefiles/untitled.brd from above]

Board: 2 copper layers, 55.7 x 32.7 mm, 85 parts (0 on the bottom side), 64 nets.
