noelledavis/sweat-wearable-old/eric4/fullboard_eaglefiles/untitled.brd

## EAGLE design eric4/fullboard_eaglefiles/untitled.brd (2020-10-29)

Schematic: untitled.sch

Parts:
BATT_NEG: TPTP14R; TP14R
BATT_POS: TPTP14R; TP14R
C1, C2, C3, C5, C6, C7, C9, C10, C11, C12, C13, C14, C15, C16, C17, C18, C19, C20, C21, C22, C23, C24, C25, C26, C27, C28, C31, C35, C37, C39, C40, C41, C42, C43, C44, C45, C46, C47, C48, C50, C60, C62, C63, C64, C68, C69: 0.1u; C0201
C4, C8, C57: 0.01u; C0402
C29, C36: 10uF; C0402
C30, C34, C38, C58: 1u; C0402
C32, C33, C56: 4.7u; C0402
C49, C67: 10uF; 0402
C51, C52: 0.1p; C0201
C53: 10u; C0402
C54: 2.2u; C0402
C55: 430p; C0402
C61: 0.1u; C0402
C65, C66: 20pF; C0402
D1: MBR0520LT; SOD123
J1: J-06-2MM-2X03; DIL-2MM-2X03
JUMPER: R1000; R0402
L2: 10uH; 0805
LED1: STAT1-ORANGE; CHIPLED_0805
LED2: STAT2-GREEN; CHIPLED_0805
LED3: Power-RED; CHIPLED_0805
Q1: 16M Crystal; NX3225
R1, R2, R3, R4: 4950; R0201
R5: 10k; R0402
R6, R39: 2k; R0402
R7, R8, R38: 150; 0402
R9, R10, R11, R12, R13, R14, R15, R16, R17, R18, R19, R20, R21, R22, R23, R24, R27, R28, R29, R30, R31, R32, R33, R34: 820k; R0201
R25: 13.3k; R0402
R26: 46.4k; R0402
R35, R36: 1M; R0201
R40: 10K/THERM; R0402
R42: 100k; R0201
RT1: 1K; R0402
RT2: 150K; R0402
U1: LP2985A-33DBVTE4; SOT95P280X145-5N
U2, U3, U4: LT6005IGNPBF; SOP63P600X175-16N
U5: MCP73833T-AMI/MF; DFN10_3X3MM
U10: ATMEGA328P; TQFP32-08
U15: TLE2426IDR; R_8
U$1, U$2, U$3, U$4: SOIC8_INAMPMSOP; MSOP08
U$5, U$7: LP2985A-50; SOT95P280X145-5N
U$6: AD8462; MSOP08
U$8: SPBT2632C2A
U$9: LM27313; SOT95P280X145-5N
U$10: MINI-USB-10033526-N3212LF
U$11: JS102011SAQN
U$12: 5-104074-1-CONNECTOR

Connections:
3V3_BT: C58.1, C61.1, U1.5 (VOUT), U$8.VIN
5.0V: C49.1, LED1.A, LED2.A, LED3.A, U5.P$1 (VDD1), U5.P$2 (VDD2), U$10.5 (USB5)
BATT: C67.1, JUMPER.1, U5.P$9 (VBAT1), U5.P$10 (VBAT2)
CH1_LPF1_OUT: C6.2, C7.2, R10.1, U3.1 (OUT_A), U3.2 (-IN_A)
CH1_LPF2_OUT: C11.2, C12.2, U3.15 (-IN_D), U3.16 (OUT_D), U10.25 (PC2(ADC2))
CH2_LPF1_OUT: C16.2, C17.2, R23.1, U3.6 (-IN_B), U3.7 (OUT_B)
CH2_LPF2_OUT: C19.2, C20.2, U3.10 (OUT_C), U3.11 (-IN_C), U10.26 (PC3(ADC3))
CH3_LPF1_OUT: C2.2, C3.2, R17.1, U2.1 (OUT_A), U2.2 (-IN_A)
CH3_LPF2_OUT: C21.2, C22.2, U2.15 (-IN_D), U2.16 (OUT_D), U10.27 (PC4(ADC4/SDA))
CH4_LPF1_OUT: C24.2, C25.2, R19.1, U2.6 (-IN_B), U2.7 (OUT_B)
CH4_LPF2_OUT: C27.2, C28.2, U2.10 (OUT_C), U2.11 (-IN_C), U10.28 (PC5(ADC5/SCL))
CTS: U10.11 (PD7(AIN1)), U$8.RTS
CURRENT_CH1: C51.2, R35.2, U$6.2 (-IN_A), U$12.P3
CURRENT_CH1_LPF1_OUT: C44.2, C45.2, R33.1, U4.6 (-IN_B), U4.7 (OUT_B)
CURRENT_CH1_LPF2_OUT: C47.2, C48.2, U4.10 (OUT_C), U4.11 (-IN_C), U10.24 (PC1(ADC1))
CURRENT_CH2: C52.1, R36.1, U$6.6 (-IN_B), U$12.P5
CURRENT_CH2_LPF1_OUT: C35.2, C37.2, R31.1, U4.1 (OUT_A), U4.2 (-IN_A)
CURRENT_CH2_LPF2_OUT: C41.2, C42.2, U4.15 (-IN_D), U4.16 (OUT_D), U10.23 (PC0(ADC0))
DIG_VCC: C38.1, C69.1, J1.2, R42.1, U10.4 (VCC), U10.6 (VCC), U$7.5 (VOUT)
GND: BATT_NEG.TP, C1.2, C4.2, C5.2, C8.2, C9.2, C10.2, C13.2, C14.2, C15.2, C18.2, C23.2, C26.2, C29.2, C30.2, C31.2, C32.2, C33.2, C34.2, C36.2, C38.2, C39.2, C40.2, C43.2, C46.2, C49.2, C50.2, C53.2, C54.2, C56.2, C57.2, C58.2, C60.2, C61.2, C62.2, C63.2, C64.2, C65.2, C66.1, C67.2, C68.2, C69.2, J1.6, Q1.2 (G2), Q1.4 (G1), R25.1, R39.1, R40.1, RT2.1, U1.2 (GND), U2.13 (V-), U3.13 (V-), U4.13 (V-), U5.P$5 (GND), U10.3 (GND), U10.5 (GND), U10.21 (AGND), U15.2 (COMM), U$1.5 (VSS), U$2.5 (VSS), U$3.5 (VSS), U$4.5 (VSS), U$5.2 (GND), U$6.4 (V-), U$7.2 (GND), U$8.GND, U$9.2 (GND), U$10.1 (USB1), U$11.3
unnamed: R3.1, U$3.3 (RG-)
unnamed: R3.2, U$3.2 (RG+)
unnamed: R2.2, U$2.2 (RG+)
unnamed: R2.1, U$2.3 (RG-)
unnamed: R1.2, U$1.2 (RG+)
unnamed: R1.1, U$1.3 (RG-)
unnamed: R4.2, U$4.2 (RG+)
unnamed: R4.1, U$4.3 (RG-)
unnamed: LED1.C, R7.2
unnamed: LED2.C, R8.2
unnamed: R7.1, U5.P$3 (STAT1)
unnamed: C5.1, R14.2, U3.3 (+IN_A)
unnamed: C10.1, R11.2, U3.14 (+IN_D)
unnamed: C6.1, C7.1, R13.2, R14.1
unnamed: R20.1, U$2.7 (OUT)
unnamed: C11.1, C12.1, R10.2, R11.1
unnamed: R13.1, U$1.7 (OUT)
unnamed: C1.1, R12.2, U2.3 (+IN_A)
unnamed: C2.1, C3.1, R9.2, R12.1
unnamed: C14.1, R18.2, U2.14 (+IN_D)
unnamed: C21.1, C22.1, R17.2, R18.1
unnamed: C23.1, R16.2, U2.5 (+IN_B)
unnamed: C15.1, R21.2, U3.5 (+IN_B)
unnamed: C16.1, C17.1, R20.2, R21.1
unnamed: C18.1, R24.2, U3.12 (+IN_C)
unnamed: C19.1, C20.1, R23.2, R24.1
unnamed: C24.1, C25.1, R15.2, R16.1
unnamed: C26.1, R22.2, U2.12 (+IN_C)
unnamed: C27.1, C28.1, R19.2, R22.1
unnamed: R15.1, U$4.7 (OUT)
unnamed: R9.1, U$3.7 (OUT)
unnamed: C30.1, U15.8 (NOISE)
unnamed: C32.1, C33.1, C53.1, C55.2, D1.C, R26.2, U$5.1 (VIN), U$5.3 (ON/~OFF), U$7.1 (VIN), U$7.3 (ON/~OFF)
unnamed: J1.5, R42.2, U10.29 (PC6(/RESET))
unnamed: C4.1, U$5.4 (BYPASS)
unnamed: C65.1, Q1.1 (X1), U10.7 (PB6(XTAL1/TOSC1))
unnamed: C66.2, Q1.3 (X2), U10.8 (PB7(XTAL2/TOSC2))
unnamed: J1.3, U10.17 (PB5(SCK))
unnamed: J1.1, U10.16 (PB4(MISO))
unnamed: J1.4, U10.15 (PB3(MOSI/OC2))
unnamed: U10.30 (PD0(RXD)), U$8.TXD
unnamed: D1.A, L2.2, U$9.1 (SW)
unnamed: C8.1, U$7.4 (BYPASS)
unnamed: C31.1, R28.2, U4.3 (+IN_A)
unnamed: C35.1, C37.1, R27.2, R28.1
unnamed: C40.1, R32.2, U4.14 (+IN_D)
unnamed: C41.1, C42.1, R31.2, R32.1
unnamed: C55.1, R25.2, R26.1, U$9.3 (FB)
unnamed: C43.1, R30.2, U4.5 (+IN_B)
unnamed: C44.1, C45.1, R29.2, R30.1
unnamed: R8.1, U5.P$4 (STAT2)
unnamed: C46.1, R34.2, U4.12 (+IN_C)
unnamed: C47.1, C48.1, R33.2, R34.1
unnamed: U10.31 (PD1(TXD)), U$8.RXD
unnamed: C51.1, R27.1, R35.1, U$6.1 (OUT_A)
unnamed: C52.2, R29.1, R36.2, U$6.7 (OUT_B)
unnamed: C57.1, U1.4 (BYPASS)
unnamed: LED3.C, R38.1
unnamed: R39.2, U5.P$6 (PROG)
unnamed: R38.2, U5.P$7 (PG)
unnamed: RT1.1, U5.P$8 (THERM)
unnamed: R40.2, RT1.2, RT2.2
unnamed: U1.3 (ON/OFF), U$9.4 (SHDN_BAR), U$11.2 (COMM)
unnamed: U$1.4 (IN+), U$12.P6
RTS: U10.10 (PD6(AIN0)), U$8.CTS
TEMP_PIN2: R6.1, U10.22 (ADC7), U$12.P2
VDDA: C9.1, C13.1, C29.1, C34.1, C39.1, C50.1, C60.1, C62.1, C63.1, C64.1, C68.1, R6.2, U2.4 (V+), U3.4 (V+), U4.4 (V+), U10.18 (AVCC), U15.3 (IN), U$1.8 (VCC), U$2.8 (VCC), U$3.8 (VCC), U$4.8 (VCC), U$5.5 (VOUT), U$6.8 (V+)
VOLTAGE_CH2: U$2.4 (IN+), U$12.P7
VOLTAGE_CH3: U$3.4 (IN+), U$12.P9
VOLTAGE_CH4: U$4.4 (IN+), U$12.P10
VOLTAGE_REF: R5.2, U$1.1 (IN-), U$2.1 (IN-), U$3.1 (IN-), U$4.1 (IN-), U$12.P8
V_BAT: BATT_POS.TP, C54.1, C56.1, JUMPER.2, L2.1, U1.1 (VIN), U$9.5 (VIN), U$11.1
V_MIDSUPPLY: C36.1, R5.1, U15.1 (OUT), U$1.6 (REF), U$2.6 (REF), U$3.6 (REF), U$4.6 (REF), U$6.3 (+IN_A), U$6.5 (+IN_B), U$12.P1, U$12.P4

Notes on the sheet:
10K = 100mA
5.0K = 200mA
2.0K = 500mA
1.0K = 1000mA
No Thermistor
RT1 = 0 RT2 = NC THERM=10K
10K NTC Thermistor
RT1 = TBD RT2 = TBD

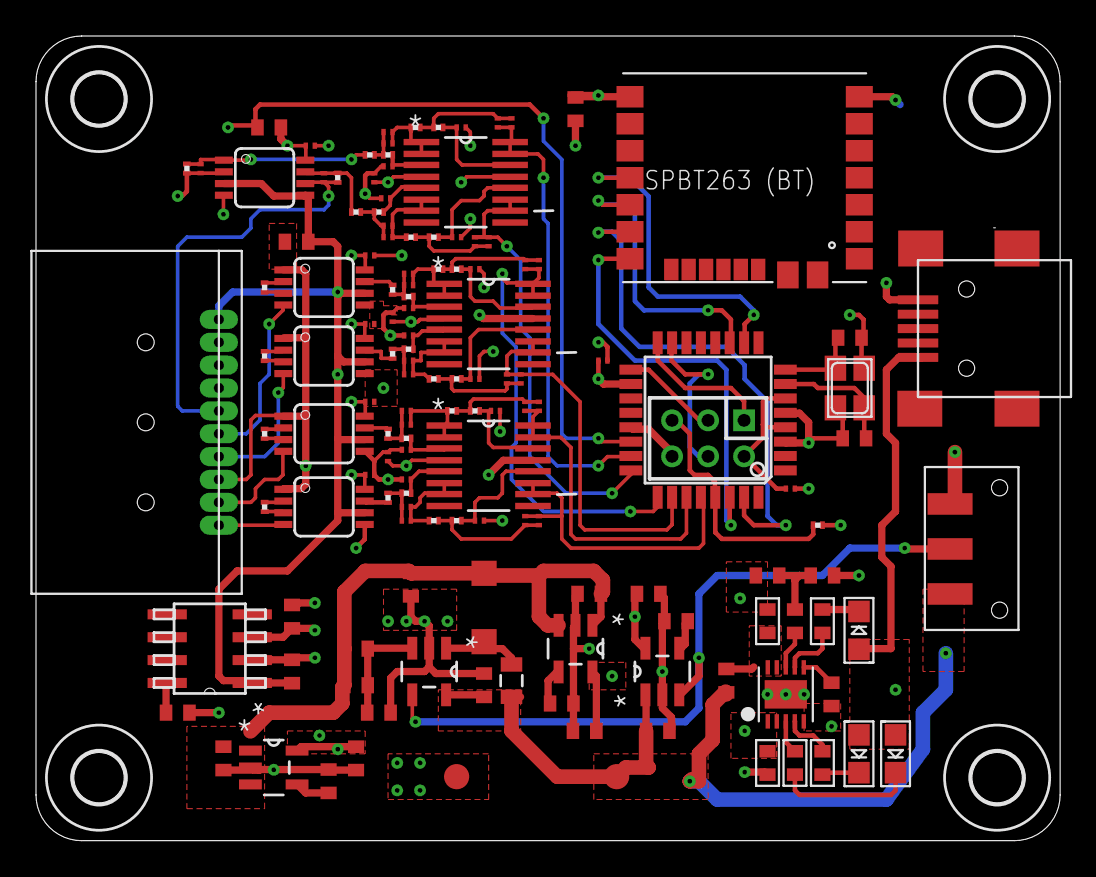
[picture p36: board eric4/fullboard_eaglefiles/untitled.brd from above]

Board: 4 copper layers, 56.9 x 44.7 mm, 143 parts (0 on the bottom side), 93 nets.

Other parts of the board:
U$13, U$14, U$15, U$16: 2,8
