noelledavis/sweat-wearable-old/electrolyte/electrolyte_firmware_FINAL/echotest/src/main.cpp

#include <Arduino.h>
byte readVal;
void setup() {
  // put your setup code here, to run once:
  Serial.begin(9600);

}

void loop() {
  // put your main code here, to run repeatedly:
  //Serial.println("Something");
  if (Serial.available() > 0) {
    readVal = Serial.read();
    Serial.write(readVal);
  }

}
