noelledavis/sweat-wearable-old/(notices)

Notices in the files:
parts and their libraries:
SparkFun-Passives: Licensing: Creative Commons ShareAlike 4.0 International - https://creativecommons.org/licenses/by-sa/4.0
con-headers-jp: Copyright (C) 2008, Bob Starr
